MarinVacarciuc/FrankenBin/(commit log)

2026-04-30 Initial concept: L293D + DVD stepper motors + HC-SR04 proximity trigger
    Lid opens when hand detected <20 cm via ultrasonic sensor.
    ESP8266 forwards Telegram commands (OPEN/CLOSE/LOCK) to Arduino
    over hardware Serial. L293D spider driver controls two DVD stepper
    motors in 4-phase sequence.
2026-05-09 Replace DVD steppers with KT0905 linear actuator + 5-state FSM
    DVD motors lacked torque to lift the metal lid.
    KT0905 (5V, 6N, 30mm stroke) + TB6612FNG driver solved the problem.
    Added second HC-SR04 inside the lid: holds open while someone is
    present, then measures fill level after closing.
    Introduced FSM: IDLE / OPENING / OPEN / CLOSING / FULL.
    [arduino_main.ino]
2026-05-11 Add DFPlayer Mini audio + DHT11 climate sensor
    DFPlayer Mini plays a startup jingle, random welcome tracks on open,
    and complaint tracks when bin is full. BUSY pin (D4) prevents closing
    while audio is mid-playback to avoid cutting off a phrase.
    DHT11 on pin 7 reports temperature every 5 s over Serial; lays the
    groundwork for fire-alarm logic in a later iteration.
    [arduino_main.ino]
2026-05-21 Refine FSM + STATUS now shows fill %, temperature, humidity
2026-06-08 Fix premature close: add 250 ms post-play delay for DFPlayer BUSY assertion
    [arduino_main.ino]
2026-06-10 Add AVR watchdog (4 s) + EEPROM crash flag — Telegram alert on recovery
    [arduino_main.ino, nodemcu_gateway.ino]
2026-06-14 v3.4: fix mute desync — wait for Arduino MUTE: confirm; add Source Code button
    [nodemcu_gateway.ino]
2026-06-16 FrankenBin v3.5: SOUND: protocol, double-r reset guard, volume % in keyboard
    [arduino_main.ino, nodemcu_gateway.ino]
2026-06-17 v3.6: fix WDT ISR, button hold, double fire alert, DHT debounce, serial overflow
    [arduino_main.ino, nodemcu_gateway.ino]
2026-06-17 v3.7: non-blocking OPENING and FIRE_ALARM via actuator driver (no more delay(2500))
2026-06-17 Easter egg: /laws command — Three Laws of Robotics mapped to real firmware features
2026-06-17 Polish: FrankenBin in laws text, snprintf status, /reset owner-only
    [arduino_main.ino, nodemcu_gateway.ino]
2026-06-17 Fix: replace D6/D7 aliases with GPIO12/13 for board-agnostic compilation
    [nodemcu_gateway.ino]
2026-06-17 Fix WDT: clear WDRF before enabling, add wdt_reset() guard in enableWatchdog()
    [arduino_main.ino]
2026-06-17 Restore firmware to working v3.3 base + improvements
    - Telegram: password-protected board resets (OTA password), with the
    password message auto-deleted from the chat afterwards
    - Telegram: /laws easter egg and Source Code link in Details
    - Audio: volume buttons now auto-unmute
    - Gateway: resync lid/fire/full state on Arduino SYS:BOOT (fixes the
    stuck 'lid already open' state after an Arduino reset)
    - Refresh README to match current firmware
    [arduino_main.ino, nodemcu_gateway.ino]
2026-06-17 Add hidden /firetest command and broadcast alerts to all bot users
    - /firetest: hidden Telegram command driving the real fire-alarm path
    (siren + lid shut + ALARM:FIRE) to test without heating the sensor;
    open to any bot user and logged to the session
    - Arduino: factor fire logic into triggerFireAlarm(), shared by the DHT
    trigger and the 'F' test command
    - Gateway: proactive alerts (fire, full, lid, offline, recovery) now reach
    every active session user plus the configured owner (handover-ready)
2026-06-19 Calibrate fill sensor: EMPTY_BIN_DIST 40->22 cm, PINCH_DIST 4->3 cm
    Real distance to the empty bin bottom is 22 cm; tighten the anti-pinch reverse threshold to 3 cm.
    [arduino_main.ino]
2026-06-24 Fix fire-alarm dropout and allow remote clear; add detailed code comments
    During FIRE_ALARM the periodic climate check (and its TEMP heartbeat) was skipped, so the gateway marked the Arduino offline after 20s and refused commands. The check now runs during a fire to keep the heartbeat flowing; the >=35C trigger is guarded so it does not re-fire. Telegram 'o' during a fire now follows the clear path (open + 3-minute cooldown), like the physical button. Also adds detailed inline comments throughout.
    [arduino_main.ino]
2026-09-17 Add build journey gallery to README
    Fifteen photos from 28 Apr to 23 Jun tracing the build from a bare
    NodeMCU board through the first soldered joints to the finished,
    enclosed bin. Resized and compressed for web (5.6MB total).
    Excluded one candidate photo (an Arduino IDE screenshot from 9 May)
    because it showed the real WiFi password and Telegram bot token
    on screen.
